rigr/ESP32_BLE_MSX/README.md

# BLE - ESP32 - Roland or MSX

Connect a BLE-Mouse to a Roland Sampler using a ESP32 dev-board

[Deutsches Readme](./README_de.md)

[English Readme](./README_e.md)
