rigr/ESP32_BLE_MSX/(commit log)

2026-03-20 Revise README for ESP32 MSX Mouse project
    Updated README to reflect changes in device compatibility and features.
2026-03-20 Revise README for ESP32 MSX Mouse project
    Updated README_de.md to clarify device compatibility and features.
2026-03-20 Document mouse movement sequences using pulseview
    Added sequences of mouse movements recorded with pulseview, including x- and y-axis movements.
2026-03-20 upload
    arduino code to use a BLE mouse for a Roland S-750 sampler.
2026-03-21 Document pinout and electrical limitations for ESP32
    Added section on pinout and electrical limitations for ESP32.
2026-03-22 Rename Ohne Titel 2.png to boards.png
2026-03-22 Create build.md with dev-board and pinout details
    Added documentation for dev-boards and Roland mouse port pin assignment.
2026-03-22 add link to build.md
    Corrected a typo in the README regarding pin assignments and added a note about using a 9-pin cable.
2026-03-26 Update ESP32_MSX.ino
    show ID in webform
2026-03-26 Duplicate GitHub link in device info section
    cleanup webinterface
